yj-c-oo/SoC_MicroBlaze_AXI_Peripheral/MicroBlaze_I2C/vitis_workspace/MicroBlaze_I2C/src/HAL/GPIO/GPIO.h

/*
 * GPIO.h
 *
 *  Created on: 2026. 4. 28.
 *      Author: kccistc
 */

#ifndef SRC_HAL_GPIO_GPIO_H_
#define SRC_HAL_GPIO_GPIO_H_

#include <stdint.h>
#include "xparameters.h"

typedef struct {
    uint32_t CR;
    uint32_t IDR;
    uint32_t ODR;
} GPIO_Typedef_t;

#define GPIOA_BASE_ADDR XPAR_GPIO8_0_S00_AXI_BASEADDR
#define GPIOB_BASE_ADDR XPAR_GPIO8_1_S00_AXI_BASEADDR
#define GPIOC_BASE_ADDR XPAR_GPIO8_2_S00_AXI_BASEADDR

#define GPIOA       ((GPIO_Typedef_t *) (GPIOA_BASE_ADDR))
#define GPIOB       ((GPIO_Typedef_t *) (GPIOB_BASE_ADDR))
#define GPIOC       ((GPIO_Typedef_t *) (GPIOC_BASE_ADDR))

#define GPIOA_CR  (*(uint32_t *) (GPIOA_BASE_ADDR + 0x00))
#define GPIOA_IDR (*(uint32_t *) (GPIOA_BASE_ADDR + 0x04))
#define GPIOA_ODR (*(uint32_t *) (GPIOA_BASE_ADDR + 0x08))

#define GPIOB_CR  (*(uint32_t *) (GPIOB_BASE_ADDR + 0x00))
#define GPIOB_IDR (*(uint32_t *) (GPIOB_BASE_ADDR + 0x04))
#define GPIOB_ODR (*(uint32_t *) (GPIOB_BASE_ADDR + 0x08))


#define GPIO_PIN_0 0x01
#define GPIO_PIN_1 0x02
#define GPIO_PIN_2 0x04
#define GPIO_PIN_3 0x08
#define GPIO_PIN_4 0x10
#define GPIO_PIN_5 0x20
#define GPIO_PIN_6 0x40
#define GPIO_PIN_7 0x80

#define INPUT 0x00
#define OUTPUT 0x01

#define SET 1
#define RESET 0

void GPIO_SetMode(GPIO_Typedef_t *GPIOx, uint32_t GPIO_Pin, int GPIO_Dir);
void GPIO_WritePin(GPIO_Typedef_t *GPIOx, uint32_t GPIO_Pin, int level);
uint32_t GPIO_ReadPin(GPIO_Typedef_t *GPIOx, uint32_t GPIO_Pin);
void GPIO_TogglePin(GPIO_Typedef_t *GPIOx, uint32_t GPIO_Pin);
void GPIO_WritePort(GPIO_Typedef_t *GPIOx,int data);
uint32_t GPIO_ReadPort(GPIO_Typedef_t *GPIOx);


#endif /* SRC_HAL_GPIO_GPIO_H_ */
