yj-c-oo/SoC_MicroBlaze_AXI_Peripheral/MicroBlaze_I2C/vitis_workspace/MicroBlaze_I2C/src/ap/I2CApp/I2CApp.h

#ifndef SRC_AP_I2CAPP_I2CAPP_H_
#define SRC_AP_I2CAPP_I2CAPP_H_

#include "../../driver/FND/FND.h"
#include "../../driver/Button/Button.h"
#include "../../HAL/I2C/I2C.h"
#include "../../common/common.h"

void I2CApp_Init(void);
void I2CApp_Execute(void);

#endif /* SRC_AP_I2CAPP_I2CAPP_H_ */
