yj-c-oo/SoC_MicroBlaze_AXI_Peripheral/MicroBlaze_I2C/vitis_workspace/MicroBlaze_I2C/src/driver/Button/Button.h

/*
 * Button.h
 *
 *  Created on: 2026. 4. 28.
 *      Author: kccistc
 */

#ifndef SRC_DRIVER_BUTTON_BUTTON_H_
#define SRC_DRIVER_BUTTON_BUTTON_H_

#include "../../HAL/GPIO/GPIO.h"
#include "../../common/common.h"



typedef enum {
	RELEASED = 0,
	PUSHED
} button_state_t;

typedef enum {
	NO_ACT = 0,
	ACT_RELEASED,
	ACT_PUSHED
} button_act_t;

typedef struct {
	GPIO_Typedef_t *GPIOx;
	uint32_t GPIO_Pin;
	button_state_t prevState;
} hBtn_t;

void Button_Init(hBtn_t *hbtn, GPIO_Typedef_t *GPIOx, uint32_t GPIO_Pin);
button_act_t Button_GetState(hBtn_t *hbtn);
button_state_t Button2_GetState();

//hBtn_t hBtnRunStop, hBtnClear;
#endif /* SRC_DRIVER_BUTTON_BUTTON_H_ */
