yj-c-oo/SoC_MicroBlaze_AXI_Peripheral/MicroBlaze_SPI/vitis_workspace/MicroBlaze_SPI_Master/src/ap/SpiApp/SpiApp.h

// --- ap/SpiApp/SpiApp.h ---
#ifndef SRC_AP_SPIAPP_SPIAPP_H_
#define SRC_AP_SPIAPP_SPIAPP_H_

#include "../../driver/FND/FND.h"
#include "../../driver/Button/Button.h"
#include "../../HAL/SPI/SPI.h"

void SpiApp_Init(void);
void SpiApp_Execute(void);

#endif
