yj-c-oo/SoC_MicroBlaze_AXI_Peripheral/AXI_SPI_UVM_Verification/rtl/spi_master.sv

`timescale 1ns / 1ps

module spi_master (
    input logic clk,
    input logic rst,
    input logic cpol,  // idle 0: LOW, idle 1:High
    input logic cpha,  // first sampling, 0: first edge ,  1: second edge
    input logic [7:0] clk_div,
    input logic [7:0] tx_data,
    input logic start,
    output logic [7:0] rx_data,
    output logic done,
    output logic busy,
    output logic sclk,
    output logic mosi,
    input logic miso,
    output logic cs_n  //negative chip select
);

    typedef enum logic [1:0] {
        IDLE  = 2'b00,
        START,
        DATA,
        STOP
    } spi_state_e;

    spi_state_e state;

    logic [7:0] div_cnt;
    logic half_tick;
    logic [7:0] tx_shift_reg, rx_shift_reg;
    logic [2:0] bit_cnt;
    logic step, sclk_r;

    assign sclk = sclk_r;


    always_ff @(posedge clk or posedge rst) begin
        if (rst) begin
            div_cnt   <= 0;
            half_tick <= 1'b0;
        end else begin
            if (state == DATA) begin
                if (div_cnt == clk_div) begin
                    div_cnt   <= 0;
                    half_tick <= 1'b1;
                end else begin
                    div_cnt   <= div_cnt + 1;
                    half_tick <= 1'b0;
                end
            end
        end
    end

    always_ff @(posedge clk or posedge rst) begin
        if (rst) begin
            state        <= IDLE;
            mosi         <= 1'b1;
            cs_n         <= 1'b1;
            busy         <= 1'b0;
            done         <= 1'b0;
            tx_shift_reg <= 0;
            rx_shift_reg <= 0;
            bit_cnt      <= 0;
            step         <= 0;
            rx_data      <= 0;
            sclk_r       <= cpol;  // always cpol must change affect from sclk
        end else begin
            done <= 1'b0;
            case (state)
                IDLE: begin
                    mosi   <= 1'b1;
                    cs_n   <= 1'b1;
                    sclk_r <= cpol;
                    if (start) begin
                        tx_shift_reg <= tx_data;
                        bit_cnt      <= 0;
                        step         <= 1'b0;
                        busy         <= 1'b1;
                        cs_n         <= 1'b0;
                        state        <= START;
                    end
                end
                START: begin
                    if (!cpha) begin
                        mosi <= tx_shift_reg[7];
                        tx_shift_reg <= {tx_shift_reg[6:0], 1'b0};
                    end
                    state <= DATA;
                end
                DATA: begin
                    if (half_tick) begin
                        sclk_r <= ~sclk_r;  //Toggle 
                        if (step == 0) begin  //Receive Part
                            step <= 1'b1;
                            if (!cpha) begin
                                rx_shift_reg <= {rx_shift_reg[6:0], miso};
                            end else begin
                                mosi <= tx_shift_reg[7];
                                tx_shift_reg <= {tx_shift_reg[6:0], 1'b0};
                            end
                        end else begin
                            step <= 1'b0;  //transmit
                            if (!cpha) begin
                                if (bit_cnt < 7) begin
                                    mosi <= tx_shift_reg[7];
                                    tx_shift_reg <= {tx_shift_reg[6:0], 1'b0};
                                end
                            end else begin
                                rx_shift_reg <= {rx_shift_reg[6:0], miso};
                            end
                            if (bit_cnt == 7) begin
                                state <= STOP;
                                if (!cpha) begin
                                    rx_data <= rx_shift_reg;
                                end else begin
                                    rx_data <= rx_shift_reg;
                                    rx_data <= {rx_shift_reg[6:0], miso};  // 
                                end
                            end else begin
                                bit_cnt <= bit_cnt + 1;
                            end
                        end
                    end
                end
                STOP: begin
                    sclk_r <= 1'b0;
                    cs_n   <= 1'b1;
                    done   <= 1'b1;
                    busy   <= 1'b0;
                    mosi   <= 1'b1;
                    state  <= IDLE;
                end
                default: begin
                    state <= IDLE;
                end
            endcase
        end
    end
endmodule
